jamargevicius/LoRa-Modem-with-ESP32/schematic - eSoil Rx rev proto 1.docx

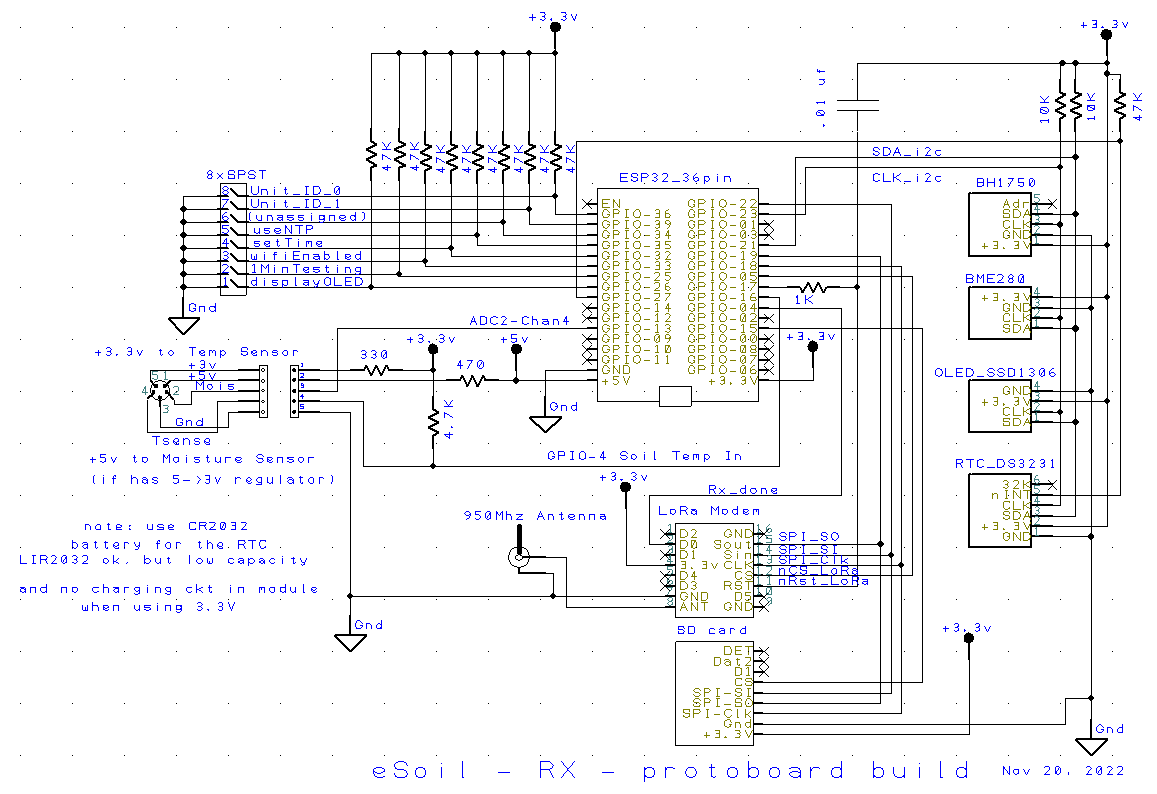
[picture p1: figure]
