jamargevicius/LoRa-Modem-with-ESP32/schematic - eSoil Tx rev proto 1.docx

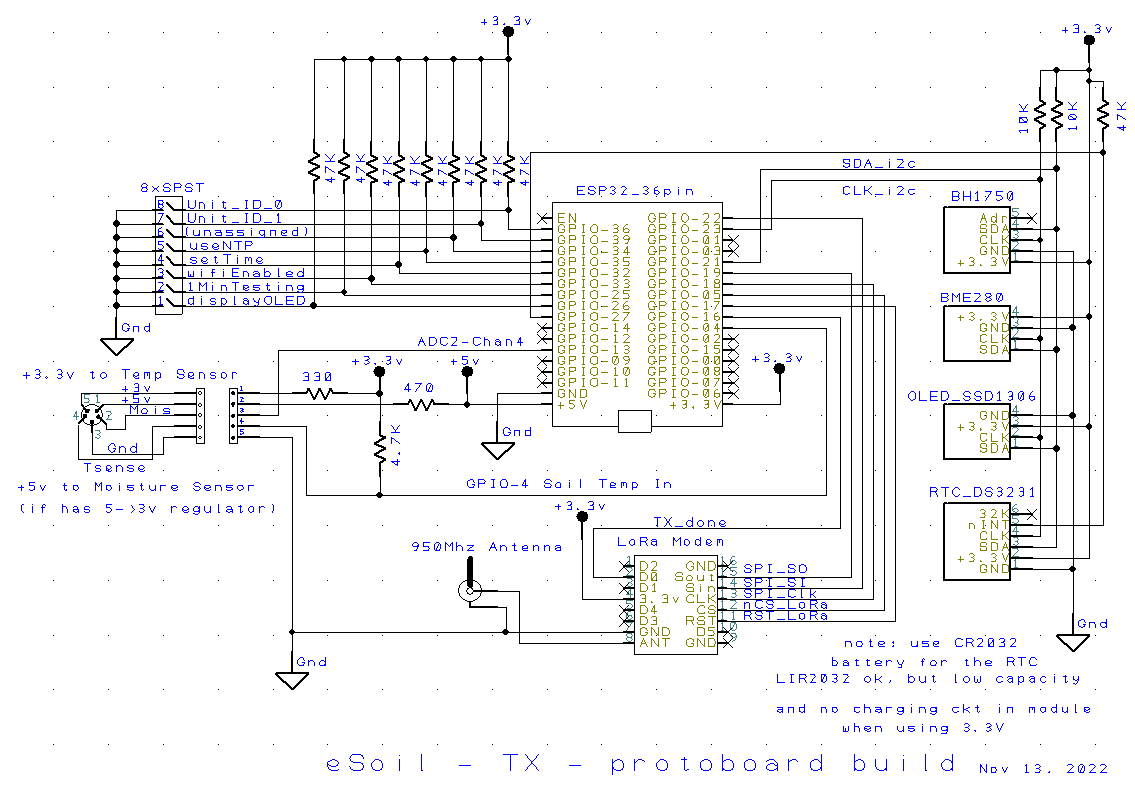
[picture p2: figure]
